RizkiTriamadewa/Smart-Car-Line-Follower/README.md

Smart Car Line Follower 5channel IR and 2 Controller
