RizkiTriamadewa/Smart-Car-Line-Follower/TROBOSAN/SOLIDWORKS/Bawah NEW.DXF

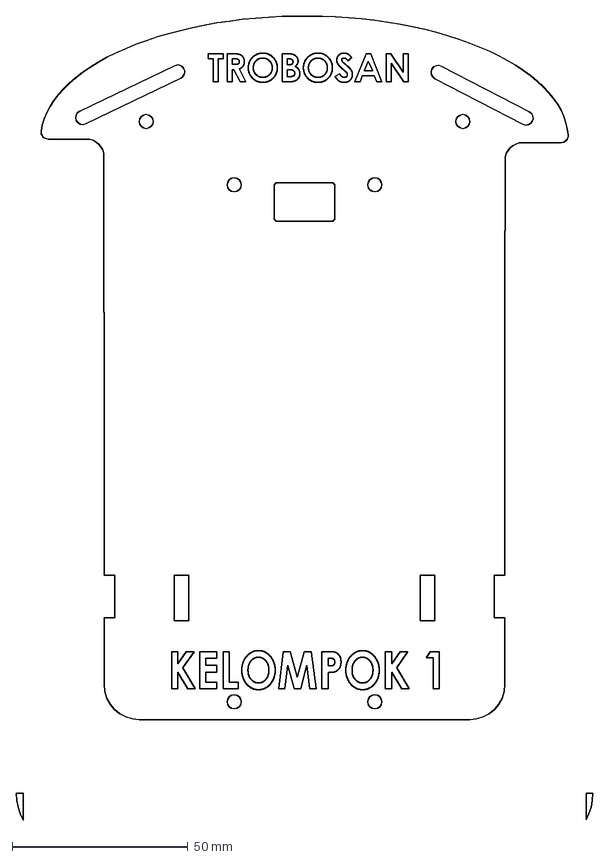
[picture p54: CAD file, 2025-03-24]
TROBOSAN/SOLIDWORKS/Bawah NEW.DXF
163.9 x 228.6 mm
