RizkiTriamadewa/Smart-Car-Line-Follower/TROBOSAN/SOLIDWORKS/Atas NEW.DXF

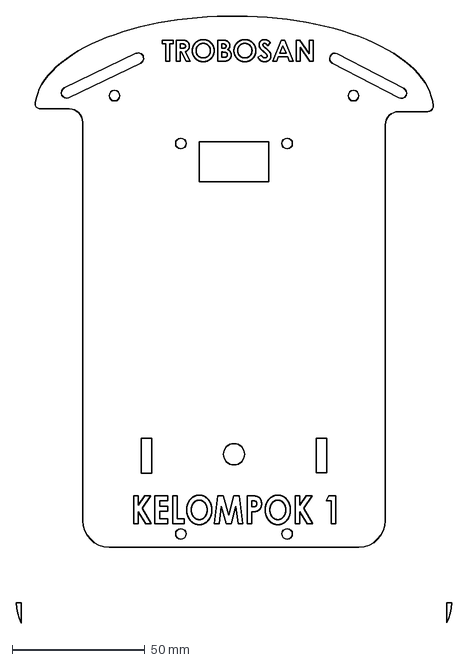
[picture p55: CAD file, 2025-03-24]
TROBOSAN/SOLIDWORKS/Atas NEW.DXF
163.9 x 228.5 mm
