RizkiTriamadewa/Smart-Car-Line-Follower/TROBOSAN/SOLIDWORKS/Bawah.SLDPRT

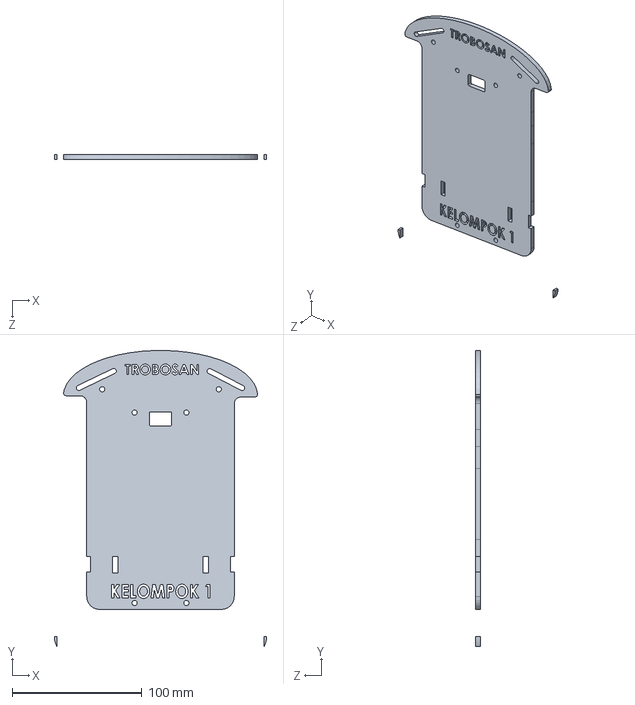
[picture p56: CAD file, 2025-03-24]
TROBOSAN/SOLIDWORKS/Bawah.SLDPRT
163.9 x 228.5 x 4.00 mm
