RizkiTriamadewa/Smart-Car-Line-Follower/TROBOSAN/SOLIDWORKS/Atas.SLDPRT

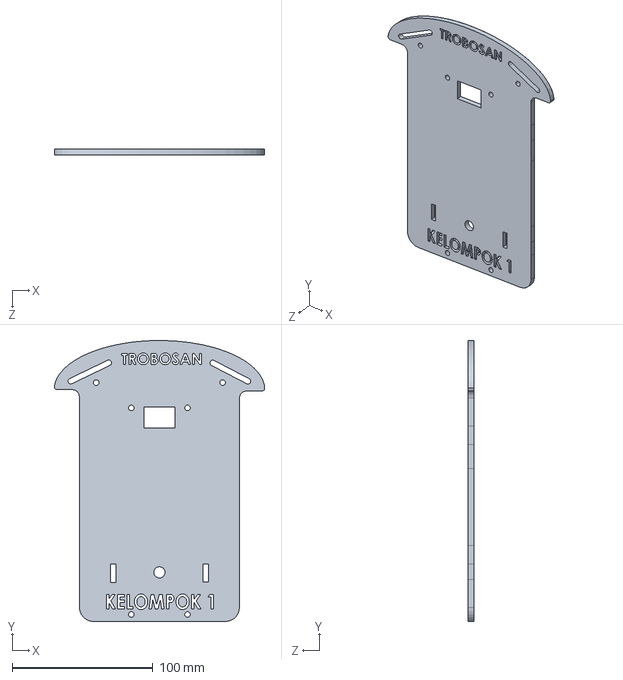
[picture p57: CAD file, 2025-03-24]
TROBOSAN/SOLIDWORKS/Atas.SLDPRT
149.8 x 200.0 x 4.00 mm
